Z-Coder672/P.A.R./Arduino Code/PARMain/FLOW.md

# P.A.R.Main Flow

## Hardware in 5 seconds

| Thing | What it does |
|---|---|
| Arduino Nano ESP32 | Main brain — WiFi, HTTP, NTP clock, servo, color sensor |
| Arduino Mega + GRBL | Motion controller — moves the gantry via `Serial1` (D0/D1) |
| ServoNano link (D9 TX, D2 ack) | `Serial2` TX-only to a dedicated 5 V Nano, which drives the flip servo (black ↔ blue). D2 reads its ack level |
| TCS3200 (D4–D8) | Color sensor — reads which side of a disc is showing |
| LED bank (D10) | Illumination for the ambient-subtracted read; HIGH = on |
| VL53L4CD (A4/A5, I²C) | ToF ranger — per-cell standoff, daily 10:00 scan only |

Full wiring — every pin, both boards, the GRBL/CNC-shield map and the ack divider — is in **`Arduino Code/PINOUT.md`**.

---

## Boot (`setup`)

1. **Init grid coords** — 37×18 = 666 cells, each mapped to a physical (X, Y) in mm (negative coords because GRBL homes to full-negative). Starting X offset = 25 mm.
2. **Bring up the servo link** (`Serial2`, TX-only on D9) and park the arm at `SERVO_US_REST` = 565 µs ≈ **2°** — not 0°. 544 µs is the Servo-library 0° floor and still appears as that floor in `SERVO_US_0DEG`/`SERVO_US_MIN`, in `compensatedUs()`'s degree mapping and in ServoNano's parse guard; it is **not** the rest angle.
3. **Configure TCS3200** — S0/S1 = HIGH/LOW → 20% freq scaling (full speed is too fast to measure)
4. **Connect WiFi** → `timeBegin()` starts NTP → `timeWaitForSync(30 s)` (bounded only so a dead network can't wedge `setup()` — failure unlocks nothing) → `cadenceLoadRecord()` reads the last lidar scan's date off flash → `lidarEnsure()` brings the VL53L4CD up so a wiring fault surfaces in the log at boot, not at 10:00. The boot `scanGrid()` is commented out — the first color scan happens lazily in `loop()` (first job, `gridStateFresh` false).

**`setup()` never moves the gantry.** GRBL bring-up (`$H` homing, `$1=255`, `G21`/`G90`) lives in `grblBringup()`, called from `loop()` only after `cadenceGate()` says the rig is clear to operate — trusted time-server clock AND daytime. A brownout reboot at 02:00, or a boot with NTP unreachable, sits parked (servo at REST, not one byte of G-code) instead of homing at night. The boot-time night sleep and the "we booted at 14:00 and still owe today's lidar scan" case are likewise handled by `cadenceGate()`, so the whole schedule lives in one place.

---

## Main Loop (`loop`)

```
cadence gate → no trusted time-server clock? → HOLD PARKED (no motion, no polling), retry in 30 s
             → night (20:30–09:59), re-checked after EVERY wake? → sleep until 10:00
             → scan owed but it's 18:00 or later? → sleep until 10:00, scan then
             → today's lidar scan not done? → run it (~50 min), persist to flash
grblBringup  → first clear daytime pass since boot: home + $1=255 + G21/G90 (no-op after)
poll server  → got bitmap? → re-scan board (skipped if last action was a clean scan) → display it → check pass → snapshot request → mark complete
                             → then: night window? → sleep until 10:00 : 10 min linger
             → no bitmap?  → wait 10s → repeat
```

### Step-by-step

**0. `cadenceGate()`** — the clear-to-operate gate, before any motion or server ingestion. See **Daily Cadence** below. **HARD RULE: with no trusted time-server clock it returns false and the rig holds parked — no polling, no scanning, not even homing.** There is no "uncadenced" fallback; `loop()` just waits 30 s and retries the gate.

**1. Poll** — `fetchNext()` opens a raw TLS socket to the server, `POST /next.php` with an `X-Snapshot-Secret` header (must be POST — intermediates may silently retry GETs, and each retry would pop a queue item the board never sees; the secret is required as of 2026-08-31, so **flash this sketch before deploying that server change** or every poll 401s). The response's `X-Gallery-Id` header is the entry id, validated digits-only by `isDigitsOnlyId()` before it is stored — it is interpolated into the `/complete.php` URL and the snapshot POST body

**2. Parse response**
- Status 200 + body = new bitmap (base64, 112 chars max)
- Body `"NONE"` or non-200 = queue empty, sleep 10s

**3. Decode** — base64 → 84 bytes = 666 bits (last 6 bits are unused padding), one bit per disc

**4. `scanGrid()` (conditional)** — re-home and re-read every cell with the TCS3200. **Skipped when `gridStateFresh` is set**, i.e. when `gridState[]` is already a *measured* picture of the board: on the first job after boot (reusing `setup()`'s scan), and after any job whose last board-touching action was a scan with no fixing after it — the check pass re-scanned and found ≤`CHECK_FIX_MAX_SKIP` wrong, or the draw flipped nothing at all (`gridStateFromScan`, carried across the idle at the end of the job). That scan already describes the final board, so repeating it costs ~70 min to learn what was just measured. Any flip after a scan makes the state *inferred* rather than measured (`displayBitmap` clears `gridStateFromScan` before its first flip), and the next job re-scans. When the scan is skipped, `rehome()` still runs if `needsRehome` is set — the end-of-job `$1=0` releases the steppers, so the gantry may have been nudged.

Otherwise the full sweep runs. It reseeds `gridState[]` so `displayBitmap` only flips cells that actually differ. The reading sweep runs with the **flip arm parked at REST** (`SERVO_US_SCAN` = `SERVO_US_REST` = 565 µs, changed 2026-08-10). It used to be dropped to ~33.5° so that — since the sensor trails the flip head by `SCAN_OFFSET_X` (−24.005 mm ≈ one cell pitch) — the lowered arm brushed the board and pushed through any squisk left at stage 1 (90°, half-rotated). That secondary settling job is abandoned: the arm now stays up for the whole scan, so the "carriage moves only with the servo at REST" invariant holds trivially (a dropped arm dragged across a populated board is what snapped the flip arm before), and half-rotated discs are no longer nudged during scanning — one left mid-rotation stays mid-rotation until the check pass re-flips it. Each cell is read with **LED ambient-subtraction** and classified by a simple blue-channel threshold (see Color Classification below); ambient subtraction removed the old room-light "blown regime", so the former `SCAN_C_CEILING` guard / sensor re-init recovery is gone.

**5. `displayBitmap()`** — over the band of rows that contain at least one differing cell, flip cells where `desired bit ≠ gridState`. Rows with no differing cells are **skipped entirely** (no move to them — the next flipping row is still entered via `moveToYSafe`, so Y travel stays at an X soft-limit). Returns the number of cells flipped (= cells that were wrong vs the target), used to gate the check pass.

**5b. Check pass** — after the first `displayBitmap()` completes, conditionally re-scan + re-fix. Two short-circuits, both keyed on `CHECK_FIX_MAX_SKIP` (=5):
- **First draw flipped ≤5 cells** → tiny job, few chances to fail → **skip the whole check pass** (no re-scan, no re-fix).
- **Otherwise** → re-run `scanGrid()` (reseeds `gridState[]` from the physical board, catching discs that didn't flip cleanly or were misclassified), then count mismatches vs the target. Re-run `displayBitmap()` **only if >5 cells are still wrong**; ≤5 are left as-is. The color sensor is ~99.5% accurate, so a full 666-cell scan misreads ~3 cells on average — ≤5 mismatches sit within that noise floor, so re-flipping them would more likely flip a *correct* disc than fix a real miss. Tolerating ≤5 doesn't lower display accuracy. One corrective pass at most.

When the check pass ends on that skip-the-fix branch, its scan is the last thing that touched the board — so it is carried over as the *next* job's scan (see step 4) instead of being thrown away.

**6. `flipDisc(x, y, catchByNextMove, inverted)`** — two-stage 180° rotation (+ optional second catch)

> **Servo-angle regime (changed 2026-08-09, merged from `FlipAllTest`).** `SERVO_US_RELEASE` went **1018 → 807** (≈46° → ≈25.5°) and `SERVO_US_ENGAGE` **1471 → 1317** (≈90° → 75°), and the release angle is now **lidar-standoff compensated per cell** instead of commanded raw. Those base angles are only valid **as a set** with the compensation (`RELEASE_EXTRA_REACH_MM`, `LIDAR_FIT_CMM`, `RELEASE_EDGE_ROW_TRIM_MM`) and with the target trims (`FLIP_TARGET_OFFSET_X`, `FLIP_NONINVERT_OFFSET_X`, `FLIP_SKEW_X_TOP` −1.5, `FLIP_CATCH_EXTRA_X`, the unload). Porting one half without the other leaves the flip wrong by tens of degrees. `SERVO_US_SCAN` was deliberately **pinned to the literal 889 µs** (~33.5°) rather than left derived from `SERVO_US_RELEASE` — the scan sweep is not part of the flip tuning and following RELEASE down would have raised the sweeping arm ~20°.

The absolute flip X is
`grid[y][x].x + FLIP_TARGET_OFFSET_X + flipSkewX(y) + (inverted ? FLIP_INVERT_OFFSET_X : FLIP_NONINVERT_OFFSET_X)`.
- `FLIP_TARGET_OFFSET_X` = **+2.0 mm** — global landing trim, every cell, +X = away from homing.
- `flipSkewX(y)` — linear column-lean correction, anchored at the **bottom** row: 0 at `y = GRID_H-1`, `FLIP_SKEW_X_TOP` (**−1.5 mm**, toward homing/−X) at `y = 0`. Net landing is +2.0 mm on the bottom row and +0.5 mm on the top row. Only the flip head shifts — scanning still targets cell centers.
- `FLIP_NONINVERT_OFFSET_X` = **−0.5 mm** on RTL rows only — a residual registration difference between the two sweep directions (the LTR/inverted direction is the confirmed-correct reference). Distinct from `FLIP_INVERT_OFFSET_X`, which compensates for hitting the opposite *face* of the squisk.

`inverted` is passed on **left-to-right sweep rows** (`ltr` in `displayBitmap`) and mirrors the whole X excursion: `dx = −FLIP_OFFSET_X`, so the arm clears the disc column toward −X and catches on the +X return. Two effects: the catch drives the squisk through its final 90° in the opposite rotational sense, so LTR rows **unwind the column-rod twist** the RTL rows wind in; and the return slide — the flip's last motion — now ends in the direction the sweep is already heading, so an LTR row no longer backtracks 16.8 mm before every next cell. **RTL rows keep the original flip** for exactly that reason: their −X return already points along the sweep. Coming at the disc from the other side puts the arm on the opposite face of the squisk, hence the **+11.0 mm** (`FLIP_INVERT_OFFSET_X`) shift of the flip target on inverted rows.

```
move gantry to disc (fx = cell X + 2.0 + skew + (inverted ? +11.0 : -0.5))
servo → ENGAGE (75°)   → settle 300ms  # rotates squisk 90°; NOT compensated
G91; X -unload; G90                    # arm unload, still at ENGAGE (1.5 mm, 4.0 mm on the off-board edge cell)
servo → REST (2°)      → settle 300ms
G91; X (dx + unload); G90              # clearing slide — lands at cell + dx regardless of the unload
servo → RELEASE (compensatedUs, ~845..983µs) → settle 100ms
G91; X (-dx ∓ FLIP_CATCH_EXTRA_X); G90 # catch stroke — sweeps 3.5 mm PAST the cell origin
#ifdef FLIP_SECOND_CATCH               # default OFF — commented-out //#define near FLIP_OFFSET_X
  servo → RELEASE2 (compensated)→ settle 100ms  # second catch: arm a further ~10° lower
  if !catchByNextMove:                  # only when the next move won't already do it
    G91; X +dx2; G90                    # explicit +X sweep (opposite the return)
    servo → REST (2°)    → settle 100ms
#else                                   # second catch disabled
  servo → REST (2°)      → settle 100ms # park; catchByNextMove ignored
#endif
```

**Arm unload.** At ENGAGE the arm is bearing against the squisk it just rotated, so before the servo lifts to REST the head backs off **opposite** the coming clearing slide — taking the contact force off the arm so it lifts away cleanly instead of dragging a loaded disc. The clearing slide then travels `dx + unload`, so net motion from the cell origin is unchanged. `FLIP_UNLOAD_X = 1.5 mm` normally; `FLIP_UNLOAD_X_EDGE = 4.0 mm` **only where the unload travels off the board**, which is direction-matched, not column-symmetric: `usesEdgeUnload(gx, inverted)` is `gx == GRID_W-1` on LTR/inverted rows (unload runs +X, off the right edge) and `gx == 0` on RTL rows (unload runs −X, off the left edge). Any other pairing would back 4 mm **into** the neighbouring populated column — do not "restore the symmetry". Set `FLIP_UNLOAD_X = 0.0f` to disable the feature entirely.

**Catch stroke.** The return travels `−dx` **plus `FLIP_CATCH_EXTRA_X` (3.5 mm) further in the same direction**, so the arm sweeps past the cell origin instead of stopping on it — that is what completes the second 90° consistently. Only the return is lengthened; the clearing slide stays at `FLIP_OFFSET_X`. Each cell re-establishes absolute X with `moveTo(fx)`, so the extra travel cannot accumulate.

**Lidar standoff compensation** (`LIDAR_COMP_MODE 1` — every cell). The arm is a lever that lies flat on the platform at `ARM_FLAT_DEG` (23°), so its perpendicular reach is `ARM_LEN_MM·sin(θ − FLAT)`; a cell whose standoff exceeds `LIDAR_REF_MM` (37.69) by *d* needs *d* more reach, giving `θ' = FLAT + asin(sin(θ − FLAT) + d/ARM_LEN_MM)`. `compensatedUs(baseUs, gx, gy)` applies that to `SERVO_US_RELEASE` per cell from the `LIDAR_FIT_CMM[18][37]` rod-bend table, and adds two terms **outside** the comp gate: `RELEASE_EXTRA_REACH_MM` (+4.496 mm global — shortened pusher pin, plus the +60 µs that holds the top rows steady under the 2026-08-20 re-tilt) and `RELEASE_EDGE_ROW_TRIM_MM` (−0.5 mm on the **top and bottom rows only**, whose rods sit closest to their mounts, are stiffest, and over-push at the interior's reach). Result over the board: **845..983 µs, mean 913**; nothing clamps at `SERVO_US_MIN`. The `LIDAR_FIT_CMM` vertical gradient was **re-tilted 2026-08-20** (+0.2972 mm/row, mean-preserving) — the pass-4 table had it inverted, having subtracted a fictitious drift measured on calibration squares that move when the board does not. Four independent full-board scans put bottom−top at **+1.67 mm [+1.35, +1.98]** where the old table said −1.24 mm. `ARM_LEN_MM` is the arm's length — the pin trim is a linear reach demand and belongs in `RELEASE_EXTRA_REACH_MM`, not in the lever arm. `LIDAR_COMP_MODE 2` (masked paired trial) exists only in `FlipAllMaskedTest`; PARMain `#error`s on it.

`dx = ±FLIP_OFFSET_X (16.8 mm)` — **− on inverted (LTR) rows, + on RTL rows** — and every stroke (clearing, unload, catch-with-extra) is capped so it never commands past `X=0` or `−X_TRAVEL`; the unload is *skipped* rather than clamped if it would breach. Simulated over all 666 cells × both row directions × all strokes: worst-case margins **12.775 mm at `X=0`** (col 36, row 17, RTL clearing slide) and **19.700 mm at `−X_TRAVEL`** (col 0, row 0, LTR clearing slide), zero breaches — so the caps never bind today; they're the net for future offset/pitch/skew changes.

**The second catch is gated behind `#define FLIP_SECOND_CATCH`, OFF by default** (commented `//#define` near `FLIP_OFFSET_X` — uncomment to re-enable). With it OFF the arm parks at REST after the catch stroke and `catchByNextMove` is ignored. With it ON: the catch always sweeps **+dx by ≥16.8 mm**, opposite the return — which under the mirror means *against* the row's sweep direction on both row directions. So `catchByNextMove` can no longer be folded into the caller's next move and callers pass `false`; `flipDisc` always emits its own +dx stroke and re-parks at REST. (The parameter stays in the signature so re-enabling the second catch needs no signature change.) `SERVO_US_RELEASE2 = SERVO_US_RELEASE − SERVO_US_10_DEG` — still derived, so it followed RELEASE down to 704 µs base, and it is lidar-compensated at use.

Each cell logs one plog line while the clearing slide runs: `f x<gx> y<gy> L|R rel<us> unl<tenths mm> dx<tenths mm> miss<ackMisses>`.

**7. `onDisplayComplete()`** — `GET /complete.php?id=<N>` tells the server the image is confirmed displayed.

**8. Release steppers, then linger *or* sleep** — `releaseSteppers()` sends `$1=0` + a tiny jog (`G0 X-0.1`, away from the `X=0` soft limit) to trigger the disable, and sets `needsRehome`. **Sync (`waitForIdle`) after the `$1=0` before the jog** — `$1=0` commits the settings block to the Mega's EEPROM, and grbl disables interrupts during the write, dropping the Serial1 RX bytes of anything pipelined behind it. Without the sync, the jog arrives garbled → `error:2` → the rest of the burst desyncs the `ok` accounting → 60 s `waitForIdle` watchdog → MCU reset. Same `waitForIdle`-after-`$1` guard is applied at boot and in `rehome()`.

Then the cadence decides how long to wait: `isNightHour` (≥ 20:30 **or** < 10:00, catching a job that finishes after midnight) → `sleepUntilMorning()`, otherwise the usual `delay(10 min)`. The check is here — not only at the top of `loop()` — so the rig never starts an hour-long job that would finish deep into the evening and then immediately start another. If the clock is invalid at this moment the linger runs, but the next `cadenceGate()` holds the rig parked before anything else can move.

---

## Daily Cadence

Three coupled pieces: a real wall clock, a daily lidar standoff scan, and a night sleep. The board is powered 24/7, so this is a **schedule**, not power management.

**Wall clock.** NTP over the WiFi link the poller already keeps up: `configTzTime(PAR_TZ, "pool.ntp.org", "time.nist.gov")`, timezone `MST7MDT,M3.2.0,M11.1.0` (US Mountain with DST) as a named constant. Started once WiFi is up and re-asserted (idempotently) at the top of every loop; SNTP re-polls on its own and survives a WiFi bounce. **Every** cadence decision goes through `localNow(struct tm&)`, which returns false unless `clockValid()`: (a) `time()` exceeds `TIME_VALID_FLOOR` (2025-01-01 UTC — the ESP32 RTC starts at the epoch and SNTP fills it in *asynchronously*, so the clock is readable long before it is true), (b) at least one SNTP fix has landed this boot (`onNtpSync` notification callback stamps each one), and (c) the newest fix is under `CLOCK_MAX_SYNC_AGE_S` (24 h) old — the internal RTC only *interpolates between* time-server fixes and is never trusted on its own. **With no trusted clock the rig holds parked: no scan, no sleep-decisions, no polling, no homing — no motion of any kind** — logged once every 5 min, retried every 30 s. The 24 h age bound comfortably covers the longest NTP-less stretch (the 16 h past-cutoff sleep with WiFi dropped) while guaranteeing a rig whose network dies stops moving within a day.

**Daily lidar scan (10:00 local).** `runDailyLidarScan()` sweeps the VL53L4CD over **rows 1–17 (629 cells)** and writes the result to flash; row 0's 37 cells are projected afterwards (see **Skipped top row** below). It runs when the clock says the hour is ≥ 10 **and** the flash record's date isn't today — which covers both "it just turned 10:00" and "we rebooted at 14:00 and owe today's scan". An owed scan is only **started before 18:00** (`LIDAR_SCAN_CUTOFF_HOUR`): at/after the cutoff the day is written off — the rig sleeps to 10:00 and runs the scan on wake — rather than sweeping ~50 min into the evening and then printing into the night. Sensor mechanics are ported from `ScanColorLidarTest`: free-running at a 50 ms timing budget, one fresh 4 s window per cell (~80 samples), reduced to a **20 %-trimmed mean in tenths of a mm**; head offsets `LIDAR_OFFSET_X = +31.075` (calibrated so col 36 targets exactly the `X=0` machine limit) and `LIDAR_OFFSET_Y = SCAN_OFFSET_Y + 6.0 = +14.0` (the top row's target computes to −14.2 + 14 = −0.2, inside GRBL's envelope — this is what the `$131` 406→412 bump bought — but the head *physically* jams there, which is why row 0 is skipped). Targets are clamped on **both** axes (`clampScanY`, and `clampScanX` as the mirror safety net).

**Skipped top row (`LIDAR_SKIP_TOP_ROW`).** The colour sensor sits +8 mm above the flip head and clears row 0 fine, so `scanGrid()` is untouched. The lidar sits +14 mm, and at that height the head **jams against the frame across the right-hand end of row 0** — and since `cellAt` makes row 0 an even (L→R) row, the sweep would *end* the row at col 36, target (`X 0.0`, `Y −0.2`), hard into the corner. A jam does not necessarily raise `ALARM`: the steppers just skip, silently corrupting every later cell until the `y == 8` rehome. So the sweep starts at `LIDAR_FIRST_ROW` (= 1) and row 0 is never visited at the lidar Y. `rowsDone` still counts from row 0, so the resume arithmetic is unchanged.

`projectSkippedTopRow()` then fills row 0 per column, so the stored record stays dense at 666: a least-squares **linear** fit in row index over that column's measured cells (centred at `t = y − 9` for conditioning), evaluated at `y = 0`. **Linear, not cubic, deliberately** — the offline cubic in `ScanColorLidarTest` is fit to a smoothed multi-pass curve, while this one gets a single sweep's raw cells at sd ≈ 2.88 mm per-cell noise, and extrapolating one step past the fitted range amplifies noise with the degree. Measured against the shipped `LIDAR_FIT_CMM` as ground truth (300 noise trials, mean |error| in mm at the documented 2.88 mm noise): **linear 1.37**, quadratic 1.88, hold-nearest-row 2.31, **cubic 2.82** — the cubic is worse than not projecting at all. `LIDAR_PROJ_DEGREE` changes it. The fit is **not** anchored to `LIDAR_FIT_CMM` even though that scores better, because these records are what the offline re-fit consumes to rebuild that table. Guards: a column with under `LIDAR_PROJ_MIN_POINTS` (8) measured cells, a singular solve, or a projection landing outside the column's own measured range ±5 mm falls back to holding the nearest measured row. `topRowProjected` in the flash record flags the synthetic row; `cellsOk` counts only measured cells (629 on a clean sweep).

Readings are stored **RAW**, matching that sketch's `LIDAR_APPLY_CALIBRATION 0` run: the back-colour distance offsets are only meaningful against a same-pass colour classification, and this sweep does not run the colour sensor. A half-applied correction would be worse than none — the correction belongs in the offline fit that produces `LIDAR_FIT_CMM`.

Motion obeys the same conventions `scanGrid()` does, for the same reasons: **flip arm parked at `SERVO_US_REST` for the whole pass** (a dropped arm dragged across a populated board is what snapped it before), serpentine order via `cellAt()` so end-of-row X equals start-of-next-row X, every cross-row leg through `moveToYSafe` (pure-Y travel only at an X soft limit), intra-row moves are pure X, nothing sensed until `waitForMotion()` confirms the carriage stopped, and a mid-scan `rehome()` after row 8 so step drift can't skew the second half. Per-cell flash writes are pipelined behind the travel to the next cell, exactly as in `scanGrid`. `gridState[]` is **not** touched — no disc is flipped, so `gridStateFresh`/`gridStateFromScan` carry through unchanged; `rehome()` clears `needsRehome`. Cost is ~4.3 s/cell ≈ **50 minutes**, which is why it is scheduled once a day and not paid by the print loop.

If the ranger never initialises, `lidarEnsure()` gives up after 10 attempts (re-initing I²C between them) and — **unlike `ScanColorLidarTest`, which halts** — the rig carries on printing. The day is recorded with `sensorOk = 0` and no cells, so a dead ranger costs one day of data instead of putting the rig in a loop that re-attempts a 50-minute sweep all day.

**Flash record.** One fixed-layout `LidarScanRecord` at `/cadence.bin` on the **same LittleFS mount plog uses** — the factory `ffat` partition (`LittleFS.begin(true, "/littlefs", 10, "ffat")`; see `persistent_log.cpp` for why it is not `spiffs`). plog mounts it at boot; `cadenceFsReady()` re-calls `begin()` only as a guard for the case where that mount *failed*, which returns true immediately when the label is already mounted, so plog's files are never touched or reformatted. The struct (**version 2** since 2026-08-25) holds magic / version / grid geometry / `sensorOk` / local `(tm_year, tm_yday)` / unix epoch / OK-cell count / **the `rowsDone` + `(progYear, progYday)` checkpoint** / `topRowProjected` / `uint16_t dist10[666]` / an FNV-1a checksum over everything preceding it. `topRowProjected` reuses what was reserved padding rather than appending a field, so the layout — and therefore the version — is unchanged and no re-scan is forced on upgrade: every record ever written zeroed those bytes, and 0 is exactly right for a record whose top row really was measured. Written temp-then-rename, same crash policy as plog's rotation. Anything unexpected on load — missing, wrong size, wrong magic/version/geometry, bad checksum — is treated as "no scan on record", so the failure direction is *re-scan*, never *skip*. **The stored `(year, yday)` is the authority for "has today's scan run"**, so a reboot at any hour resumes the schedule correctly.

**The sweep checkpoints every row.** `runDailyLidarScan()` writes the record at each row boundary with `rowsDone` and the `(progYear, progYday)` of the day in progress — deliberately *separate* fields from the `(year, yday)` done-stamp, which is still written only on completion, so a partial record can never read as done. On entry, a checkpoint from **the same local day** with `0 < rowsDone < GRID_H` resumes at visit-row `rowsDone` and keeps the cells already measured; anything else starts fresh. Before this, the record was stamped only at the end, so a mid-sweep MCU reset threw the whole pass away: on 2026-08-25 a serial-noise stall (see `grblIsOk`) reset the rig 7 times between 10:00 and 12:13, each boot restarting at cell 0 and never getting past row 8 of 18 — and since `cadenceGate()` only returns once the scan is done, the rig did not poll or print for three hours. A restart now costs at most one row. **If the flash write fails, the in-RAM record still counts** (`cadenceSaveRecord` marks it valid up front): a broken FS runs the schedule RAM-only until the next reboot — costing one extra scan after that reboot — instead of re-running the 50-minute sweep on every gate pass all day.

`LidarScanRecord` is declared near the **top** of the .ino, next to `GRID_W`/`GRID_H` and far from the code that uses it, for the same reason `TcsFilter` is: the Arduino IDE injects its auto-generated forward declarations immediately above the first function in the file, so any type named in a function signature must be complete by that point.

**Night sleep (20:30 → 10:00).** `isNightHour(h, m)` is `(h > 20 || (h == 20 && m >= 30)) || h < 10`, written once so the post-print check and the boot-time check can never disagree about the boundary. The start carries a minute component (`NIGHT_START_HOUR` / `NIGHT_START_MIN`); the 10:00 wake end is on the hour, so only the start needs minutes. `sleepUntilMorning()` parks the servo at REST, releases the steppers via `releaseSteppers()` if they're still energised, then idles: `delay(30 s)` ticks until an epoch wake target — the next 10:00 local, computed with `mktime` (`tm_isdst = -1`, so a sleep spanning a DST change still ends at 10:00 wall-clock) — with an hourly heartbeat line and a **17 h backstop** (longer than the longest legitimate sleep, 18:00 → 10:00 = 16 h in the past-cutoff case; short enough that a stuck clock costs one day rather than forever). The wake condition is an epoch compare, not "hour left the night window", because the past-cutoff owed-scan case enters sleep as early as 18:00 where an hour-window test would bounce straight out. On wake it re-establishes WiFi and re-asserts NTP. Nothing is polled and nothing is ingested during the sleep. The stepper release is skipped before the first `grblBringup()` of a boot (GRBL is still in its power-on alarm and its steppers are unpowered anyway). **`cadenceGate()` re-tests the night/owed-scan condition in a `while` loop after every wake**, so a spurious exit — the 17 h backstop firing after SNTP stepped the clock — lands straight back in sleep instead of falling through to a scan or a poll at a night hour; after the morning scan it re-verifies once more before allowing the poll (a mid-scan clock step can't leak a night job).

It is a plain `delay()` loop, **not** light or deep sleep, on purpose: `delay()` yields to FreeRTOS so the idle task still feeds the watchdogs, the `millis()`-based GRBL/WiFi stall watchdogs stay coherent, and no reset-cause breadcrumb is fabricated — deep sleep would reboot the SoC, log `ESP_RST_DEEPSLEEP`, and re-run the whole homing sequence, defeating the point of that breadcrumb. The RTC free-runs without the network, so the wake decision never depends on NTP staying reachable.

Ordering in `cadenceGate()` is sleep **first**, then scan, so the morning wake always lands on the scan check and the day's first print draws against fresh standoff data.

Log lines: `ntp start`/`ntp synced`/`ntp NOT synced`, `cadence: record …`, `cadence: lidar scan begin|end`, `cadence: resuming lidar scan at row N/18`, `cadence: record saved … rowsN`, per-cell `ld y<y>c<x> <mm.t> n<samples> mn<min> mx<max>`, `cadence: row 0 lidar SKIPPED (jams at lidar Y; projected after the sweep)`, `cadence: top row projected (deg<N> fit <n>, held <n> of 37 cols)`, `cadence: sleep at HH:MM until 10:00`, `cadence: sleeping HH:MM`, `cadence: wake`, `cadence: no trusted clock - holding parked (no motion, no polling)`.

---

## Color Classification

TCS3200 measures R/G/B/Clear light frequencies, read with **LED ambient-subtraction**: `readAmbientSubtracted()` averages `AMBIENT_FLASHES` (3) off/on flashes, each subtracting a 5-frame LEDs-off (ambient) read from a 5-frame LEDs-on (lit) read. This cancels room light so the value depends only on the disc + our own LEDs.

```
if c <  SCAN_ON_CLEAR_MAX (900)  ->  cyan/on (1)
else                             ->  black/off (0)
```

Single threshold on one ambient-subtracted channel: the `c` slot of `tcsReadRGBC`, fed from
TcsFilter value 2, commanded (S2=H, S3=L). No model (the ternary classifier is retired).

**Reversed 2026-08-22.** From 2026-08-20 the code thresholded the `b` slot (value 1) at
1112. That is the wrong channel: its two populations overlap and no cut separates them.
Ground truth, 666 cells of one check-pass scan compared against the source bitmap decoded
from `gallery.php`, best achievable errors per slot: r = 7, g = 6, **b = 14**, **c = 6**.
Live on `b` at 1112 the same scan scored **24**. Corroborated across 40 earlier jobs
(ids 26–66, 26,640 cells) whose firmware thresholded `c`: 89 errors, **0.33 %**. On job 42
that firmware scored 0 errors while the best possible score on `b` was 17 — `b` was never
the channel being read, whatever the labels said.

Do **not** re-derive the channel from a sum test (unfiltered ≈ sum of filtered). That
identity does not hold on this sensor at either supply — at 3V3 the `g` slot reads ~5× the
`c` slot — and it is what produced both the "S2/S3 are crossed" theory and the 2026-08-20
reversal of it. Measure against a known bitmap; the check pass gives you one for free.

900 is the geometric mean of the clean cluster edges (cyan p95 = 494, black p05 = 1651).
The error count is flat at 6–7 anywhere from ~700 to ~1400, so it sits mid-plateau.
Separation at 3V3 is 4.93× (black p05 / cyan p95) against a 5 V-era median of 5.52×.
**It is supply-dependent** — re-derive if the TCS3200 moves off 3V3. Old logs are not
column-comparable: slot semantics have changed twice. Full measurements are in
`PARMain.ino` at `SCAN_ON_CLEAR_MAX`; wiring is in `Arduino Code/PINOUT.md`.

**The sensor views the disc BACK**: a displayed-on (cyan-front) disc shows its black back → reads LOW; displayed-off shows its cyan back → reads HIGH. `classifyDisc` returns the FRONT/displayed color (`on = channel below threshold`), matching `gridState`'s convention. Ambient subtraction removed the old "blown regime" (bright ambient made every cell read the same → garbled draw), so the former `SCAN_C_CEILING` guard / re-init recovery is gone.

---

## GRBL Streaming

GRBL's RX buffer = 128 bytes. Code tracks how many bytes are in-flight:

- `sendGcode()` — blocks if buffer would overflow, then sends + tracks length
- `drainResponses()` — reads GRBL replies; each `ok` frees the bytes for that command
- **Response matching is tolerant, not exact.** `grblScrub()` drops non-printable bytes, then `grblIsOk()` / `grblHasError()` / `grblHasAlarm()` match on *substring*, not equality. Line noise arrives as junk glued to the front of a reply — `\xffok` (2026-08-23), then `Dok` / `Pok` / `Tok` / `Vok` / `}S?xok` (2026-08-25) — and an exact `resp == "ok"` treats each one as a lost ack: the queue slot is never dequeued, `bufferFill` never drains, and 60 s later the stall watchdog resets the MCU. `grblIsOk` accepts a line ≤ `GRBL_OK_MAX_JUNK_LEN` (8) chars containing `ok` and neither `error` nor `ALARM`; no legitimate GRBL response contains the substring `ok`, so nothing real can be swallowed. Recoveries are counted (`gRxCorruptOks`) and logged, because this masks a hardware fault
- `grblDropIdleNoise()` — called at the top of `sendGcode()`. Whenever nothing is outstanding (`bufferFill == 0` and the queue is empty), anything already in the RX buffer is either a complete unsolicited line (logged as `GRBL idle line:`) or an orphan fragment with no newline, which is dropped before the next genuine `ok` can complete the line around it. That fragment *is* the corruption mechanism above
- `waitForMotion()` — sends `G4 P0` (dwell) + `waitForIdle()` so `ok` means motion *actually finished*, not just "parsed into planner"

---

## Error handling

| Situation | Response |
|---|---|
| GRBL `error:N` | Re-send the same command, up to `MAX_ERROR_RETRIES` (10) at 3 s spacing per same-command run; a clean `ok` resets the counter. Exhausted → park servo → `esp_restart()` |
| GRBL `ALARM` | `grblAlarmRecover()` — Ctrl-X soft reset → `$H` → reassert modals → clear the queue → force a re-scan next job. Any sub-step failing → `esp_restart()` |
| GRBL comms wedged (60 s no progress) | `grblStallReset()` — park servo → `esp_restart()` |
| Reply corrupted by line noise | `grblScrub()` drops non-printables; `grblIsOk`/`grblHasError`/`grblHasAlarm` match by substring so a surviving printable junk byte can't lose the ack. Counted in `gRxCorruptOks` / `gRxIdleDropped` |
| Servo command unacked (`SERVO_ACK_MODE 2`) | Re-send and **retry forever**. Blocking is the safe failure: every call site is reached with GRBL idle. Deliberately does *not* reset — a reset re-homes, and homing with the arm possibly at ENGAGE is how the arm broke |
| WiFi down > 60 s | Park servo → `esp_restart()` |
| `next.php` poll failure | Log, wait 10s, retry |
| Bitmap wrong length | Log, wait 10s, retry (the 10s back-off is load-bearing — `next.php` pops an item per call, so retrying with no delay would drain the queue) |
| `snapshot-request.php` failure | Log only. **No retry** — a missed snapshot just leaves `gallery/<id>/image.*` absent |
| `complete.php` failure | Exponential back-off 1s→60s over a 5-minute budget; on exhaustion the id is dropped and the entry stays `pending` server-side |
| VL53L4CD init fails ×10 | Log, record the day with `sensorOk = 0`, **keep printing** |
| NTP never syncs | HOLD PARKED — no motion, no polling, not even homing; log every 5 min, retry every 30 s |
| NTP fix goes stale (> 24 h, e.g. router dead) | Same hold-parked state as never-synced; recovers on the next fix |
