Z-Coder672/P.A.R./media/social/facebook.png

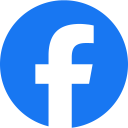
media/social/facebook.png
