Z-Coder672/P.A.R./media/social/reddit.png

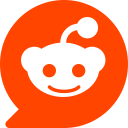
media/social/reddit.png
