Z-Coder672/P.A.R./media/social/x.png

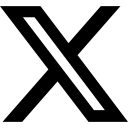
media/social/x.png
