Z-Coder672/P.A.R./PCBnSCHs/PCB_PCB3_Shield_2026-08-16_Top_Copper.png

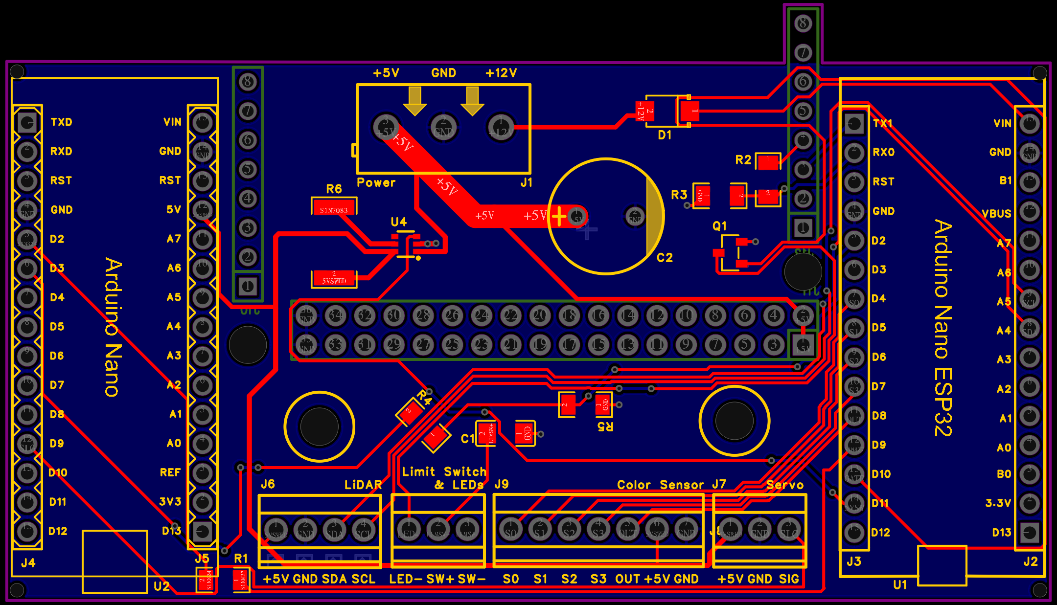
PCBnSCHs/PCB_PCB3_Shield_2026-08-16_Top_Copper.png
