Z-Coder672/P.A.R./PCBnSCHs/BOM_Board3_Shield_PCB3_Shield_2026-08-22_V7.xlsx

No. | Quantity | Comment | Designator | Footprint | Value | Manufacturer Part | Manufacturer | Supplier Part | Supplier
1 | 1 | 1nF | C1 | C1206 | 1nF | 1206B102K202NT | FH(风华) | C9196 | LCSC
2 | 1 | 1500uF | C2 | CAP-TH_BD10.0-P5.00-D1.0-FD | 1500uF | RZW152M1CBK-1025 | Lelon(立隆) | C411234 | LCSC
3 | 10 | 100nF | C3,C6,C8,C10,C12,C13,C14,C16,C17,C19 | C0603 | 100nF | CL10B104KB8NNNC | SAMSUNG(三星) | C1591 | LCSC
4 | 6 | 10uF | C4,C7,C9,C11,C15,C18 | C1206 | 10uF | CL31B106KAHNNNE | SAMSUNG(三星) | C14860 | LCSC
5 | 1 | 470uF | C5 | CAP-TH_BD8.0-P3.50-D0.6-FD | 470uF | RXK471M1CBK-0811 | Lelon(立隆) | C231191 | LCSC
6 | 1 | M7F | D1 | SMAF_L3.5-W2.6-LS4.7-RD |  | M7F | HT(金誉) | C49384260 | LCSC
7 | 1 | SMBJ5.0A | D2 | SMB_L4.3-W3.6-LS5.4-RD |  | SMBJ5.0A | PDW(芯格诺科技) | C49242966 | LCSC
8 | 1 | KF301-5.0-3P | J1 | CONN-TH_3P-P5.00_KF301-5.0-3P |  | KF301-5.0-3P | KEFA(科发) | C474882 | LCSC
9 | 4 | KH-2.54FH-1X15P-H8.5 | J2,J3,J4,J5 | HDR-TH_15P-P2.54-V-F |  | KH-2.54FH-1X15P-H8.5 | kinghelm(金航标) | C2932676 | LCSC
10 | 1 | KF128-2.54-4P | J6 | CONN-TH_4P-P2.54_KF128-2.54-4P |  | KF128-2.54-4P | KEFA(科发) | C474922 | LCSC
11 | 2 | KF128-2.54-3P | J7,J9 | CONN-TH_3P-P2.54_KF128-2.54-3P |  | KF128-2.54-3P | KEFA(科发) | C474921 | LCSC
12 | 1 | KF128-2.54-7P | J8 | CONN-TH_7P-P2.54_KF128-2.54-7P |  | KF128-2.54-7P | KEFA(科发) | C474925 | LCSC
13 | 2 | 2.54-1*8 | J10,J12 | HDR-TH_8P-P2.54-V-M |  | 2.54-1*8 | ZHOURI(洲日) | C5156616 | LCSC
14 | 1 | HC-PZ254-11.5L-2x18PZ | J11 | HDR-TH_36P-P2.54-V-M-R2-C18-S2.54-1 |  | HC-PZ254-11.5L-2x18PZ | HC(虹成电子) | C41376109 | LCSC
15 | 1 | AO3400A | Q1 | SOT-23-3_L2.9-W1.3-P1.90-LS2.4-BR |  | AO3400A | ChipNobo(无边界) | C42419946 | LCSC
16 | 1 | AO3401A | Q2 | SOT-23_L2.9-W1.3-P1.90-LS2.4-BR |  | AO3401A | AOS | C15127 | LCSC
17 | 1 | 330Ω | R1 | R1206 | 330Ω | CR1206J40331G | LIZ(丽智电子) | C102333 | LCSC
18 | 2 | 2kΩ | R2,R4 | R1206 | 2kΩ | CR1206J40202G | LIZ(丽智电子) | C102302 | LCSC
19 | 4 | 3.3kΩ | R3,R5,R10,R11 | R1206 | 3.3kΩ | CR1206F43301G | LIZ(丽智电子) | C102170 | LCSC
20 | 1 | 1kΩ | R6 | R2512 | 1kΩ | 25121WF1001T4E | UNI-ROYAL(厚声) | C54315 | LCSC
21 | 3 | 100kΩ | R7,R8,R9 | R0603 | 100kΩ | 0603WAF1003T5E | UNI-ROYAL(厚声) | C25803 | LCSC
22 | 1 | 1kΩ | R12 | R0603 | 1kΩ | RCC06031K00FKEA | VISHAY(威世) | C1859322 | LCSC
23 | 1 | MF-NSMF200-2 | U3 | F1206 |  | MF-NSMF200-2 | BOURNS | C89656 | LCSC
24 | 1 | TPS22919DCKR | U4 | SC-70-6_L2.2-W1.3-P0.65-LS2.1-BR |  | TPS22919DCKR | TI(德州仪器) | C2149796 | LCSC
