Z-Coder672/P.A.R./grbl_mega_backup.txt

$0=10
$1=255
$2=0
$3=0
$4=0
$5=1
$6=0
$10=1
$11=0.010
$12=0.002
$13=0
$20=1
$21=1
$22=1
$23=3
$24=50.000
$25=2000.000
$26=244
$27=2.500
$30=1000
$31=0
$32=0
$100=40.000
$101=40.000
$102=250.000
$110=5000.000
$111=5000.000
$112=500.000
$120=100.000
$121=100.000
$122=10.000
$130=777.695
$131=402.000
$132=200.000
