Z-Coder672/P.A.R./(commit log)

2026-05-08 Initial commit: P.A.R. LED matrix display project
    Full stack: PHP backend (queue, gallery, snapshot endpoints), vanilla-JS
    SPA frontend, Python YT-Streamer (livestream + snapshot uploader),
    Arduino sketches (main display loop, motion, color-sensor ML), and the
    PyTorch training pipeline for the disc color classifier.
    [grbl_mega_backup.txt]
2026-06-11 Add per-print recording pipeline, mod queue, and Arduino flip/logging work
    Website/PHP:
    - Per-print YouTube recording flow: stream-start/end/end-set, stream-video-id,
    latest-video endpoints and Latest-tab embed
    - Moderation queue: queue/mod-next/mod-action/migrate-mod-queue endpoints
    - Split monolithic livestream-api.php into focused endpoints
    - gallery/next/enqueue refinements; video-status
    YT-Streamer:
    - Record orchestrator + background uploader, snapshot poller, mod poller
    - Refactor RTSP -> local USB webcam via ffmpeg avfoundation (RTSP archived)
    Arduino:
    - PARMain flip/scan/classifier rework + persistent_log
    - New servo/wifi/validate test sketches; PlogDump
    [grbl_mega_backup.txt]
2026-06-11 Fix scanGrid top-row ALARM:2 + log offending move on alarm
    The top bitmap row's scan target was grid Y -1.895 + SCAN_OFFSET_Y(+4.0)
    = +2.105, past the Y=0 soft-limit edge -> GRBL ALARM:2 (target > 0).
    Raising $131 (now 402) only extends the -Y end; the +Y/Y=0 edge is capped
    at 0 regardless. clampScanY()/SCAN_Y_MAX now pin every scan Y just inside
    the envelope (top row reads ~2mm low, still on the disc).
    Also: drainResponses logs the in-flight G-code on ALARM so the next plog
    dump names the exact offending move. Sync grbl_mega_backup.txt ($131=402)
    and document the Y_TRAVEL-vs-$131 decoupling in CLAUDE.md.
    [grbl_mega_backup.txt]
2026-06-11 Sync Y_TRAVEL to $131=402 — homing anchors the grid at the -Y switch
    Homing drives to the -Y switch and GRBL pins that corner at -$131, so the
    switch is the physical coordinate anchor: Y_TRAVEL must equal $131 or the
    whole grid shifts by the difference. Update Y_TRAVEL 399.695 -> 402.0 in
    PARMain and all six mirror sketches.
    With the frame re-anchored, Y=0 now sits 2.305mm above the grid top, so
    the top-row scan target is -0.2 (was +2.105 under $131=399.695) — the
    real fix for the scanGrid ALARM:2. clampScanY stays as a safety net;
    comment updated to reflect that. Correct the prior CLAUDE.md note that
    wrongly said Y_TRAVEL and $131 are deliberately decoupled.
    [CollectColorTrainingData.ino, FlipCheckerboardTest.ino, FlipCornersTest.ino, PARMain.ino, ValidateColorModelCheckerboard.ino, ValidateColorModelLuv.ino, WiFiAfterSetupTest.ino]
2026-06-11 Surface missing-ffmpeg error distinctly from missing-camera in YT-Streamer
2026-06-11 Arm snapshot flag from Arduino post-check-pass, not next.php
    next.php no longer writes snapshot-pending.flag at queue-pop time — that
    armed the 5s snapshot poller before the draw started, capturing mid-draw
    boards. snapshot-request.php now accepts the digits-only id the Arduino
    POSTs after its check pass and writes it as the flag contents (empty for
    legacy IDless captures).
2026-06-13 Add ServoRepro sketch: hammer top-left corner flip via production servo path
    Reproduces the in-job servo failure without WiFi/scan. Strip-down knobs
    (DO_X_MOVES, DO_HOMING) at the top. Uses the bit-banged-UART -> ServoNano
    path exactly as PARMain, so the failure mode matches production.
    [ServoRepro.ino]
2026-06-13 ServoRepro: strip to servo-only max-duty (DO_X_MOVES=0) to stress power/thermal
    Carriage stationary -> both witness and main ROIs become gantry-free and
    directly comparable; ~3x servo duty cycle accelerates any sag/thermal onset.
    [ServoRepro.ino]
2026-06-13 ServoRepro: add TRAVERSE mode — loop all 4 corners for full-board wire flex
    Full X/Y travel each loop stresses the main servo's long flexing wire to the
    moving carriage, the prime suspect now that in-place flips (~520 cycles) never
    reproduced the failure with a perfect signal path.
    [ServoRepro.ino]
2026-06-13 Add ServoCenter sketch: hold servo at 90deg center, never moves carriage
    Servo PSU was cut after a carriage move broke a part. This sketch drives only
    the servo (bit-bang UART -> ServoNano) to center and never starts Serial1/GRBL,
    so it is safe to power on during reassembly.
    [ServoCenter.ino]
2026-06-13 ServoCenter: hold REST (544us / 0deg) instead of 90deg, per user
2026-06-13 ServoRepro: faithful displayBitmap loop using PARMain's safe motion
    Replaces the unsafe naive-diagonal traversal (which broke a part) with PARMain's
    exact serpentine displayBitmap + moveToYSafe + flipDisc(second-catch off), so the
    carriage only moves with the servo at REST. Toggles top+bottom rows to force 74
    flips/pass with full-board travel — a true normal-job load for the main-vs-witness
    servo diagnosis.
    [ServoRepro.ino]
2026-06-13 Add ServoCycle: zero-motion sustained servo cycling for main-vs-witness diagnosis
    Cycles the servo through flip angles forever via the ServoNano path, never
    touches GRBL/Serial1 (carriage cannot move). For reproducing 'main stops while
    witness continues' under sustained duty, with both servos in camera view.
    [ServoCycle.ino]
2026-06-13 ServoRepro: robust + logged GRBL handling for diagnostic job run
    Logs every GRBL response to USB, retries transient error:N, and parks+halts
    with a printed cause on ALARM/stall (instead of silent while(true)). Lets the
    faithful displayBitmap job survive transients and reveal why it stopped at
    flip 34, while watching for the main-servo failure (visible during top-row flips).
    [ServoRepro.ino]
2026-06-13 Add ServoYFlex: full-Y-travel wire-flex test, observe main at visible top-left corner
    Main is only visible at Y~0/X~-X_TRAVEL. This traverses Y up/down at the left
    edge (safe pure-Y at the soft-limit, servo at REST) to flex the main's long
    moving-carriage wire, cycling the servo at the top-left each iteration so the
    main can be compared against the always-visible witness.
    [ServoYFlex.ino]
2026-06-13 ServoYFlex: stress bottom-right corner (where it often fails), verify main at top-left
    Per user: failure is positional — carriage at full-right / bottom-right corner.
    Safe full-perimeter excursion (pure-Y at left edge, pure-X along bottom row, no
    diagonal field sweep), cycling the servo at the bottom-right corner and at the
    visible top-left for main-vs-witness verification.
    [ServoYFlex.ino]
2026-06-13 ServoRepro: full-board checkerboard pattern for max-volume normal-job repro
    Inverts a checkerboard each pass so every cell flips (~333 flips/pass) across
    the whole board incl. bottom-right — closest stand-in for a real job's servo
    duty + traversal, to reproduce the main-servo failure that targeted sub-motions
    (stationary, Y-flex, corner-stress) did not.
    [ServoRepro.ino]
2026-06-13 ServoRepro: log each flip cell+time for failure-cell correlation
    [ServoRepro.ino]
2026-06-13 ServoRepro: fix startMs scope (declare before displayBitmap)
    [ServoRepro.ino]
2026-06-13 Add ServoWiggleTest: hold carriage at bottom-right + cycle servo to localize main cable open
    Diagnosis: main fails on the right (max extension) while witness stays fine ->
    intermittent open in the main servo's own cable/connector when pulled taut.
    This parks at bottom-right and cycles the servo so the cable/connectors can be
    flexed by hand to find the bad spot.
    [ServoWiggleTest.ino]
2026-06-14 Add flip/scan diagnostic sketches; gitignore local image artifacts
    New bring-up sketches: FlipBottomRowBlueTest, FlipLeftColumnTest,
    FullBoardScanTest, ScanFlipRegistrationTest. Updates to PARMain.ino +
    FLOW.md and the existing Servo*/Flip* sketches; CLAUDE.md touch-ups.
    Add .gitignore rules for the root-level rig photo / bitmap-dump scratch
    (IMG_*, P.A.R. Pics/, Pics of par again yay/, centers/, consensus*,
    photo-bitmap/) so ~240MB of local debug artifacts stay out of history.
    [FlipBottomRowBlueTest.ino, FlipCheckerboardTest.ino, FlipCornersTest.ino, FlipLeftColumnTest.ino, PARMain.ino, ScanFlipRegistrationTest.ino, ServoCycle.ino, ServoRepro.ino]
2026-06-15 PARMain: sync past $1 EEPROM write before pipelining more G-code
    $1=0/$1=255 commit the settings block to the Mega's EEPROM, and grbl
    runs each changed byte under cli() with a busy-wait on EEPE — dropping
    the Serial1 RX bytes of anything pipelined right behind it. That
    garbled the end-of-job release jog into error:2, desynced the ok
    accounting, and tripped the 60s waitForIdle watchdog into an MCU reset.
    Add waitForIdle() after every $1 write (job-end release in loop(),
    boot in setup(), and rehome()) so the next line goes out only after
    the EEPROM commit's ok lands. setup() also guards the $1 sync with the
    grblStartupFault restart path. FLOW.md step 9 updated to match.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
    [PARMain.ino]
2026-06-15 Add -update 1 to snapshot grab — ffmpeg 8.x image2 muxer rejects fixed filename
    ffmpeg 8.x's image2 muxer now refuses a single fixed output filename without
    -update 1 (it wants a %d sequence pattern otherwise). It still decodes the frame
    and writes a valid JPEG, but exits non-zero, so grab_snapshot()'s returncode==0
    check treated the grab as failed and unlinked the good file — surfacing as
    "Conversion failed!" with no photo reaching the gallery. The recording sidecar
    output already had -update 1; only the standalone one-shot grab was missing it.
2026-06-15 Fix grey/corrupted recordings — pin avfoundation capture mode
    The record ffmpeg requested -framerate with no -video_size, so avfoundation
    config failed and fell back to the cam's default mode. ffmpeg then couldn't
    estimate the rate and handed libx264 a garbage ~5000fps timebase, blowing the
    H.264 MB-rate level limit — producing a grey, corrupted file.
    Pin -video_size (CAMERA_VIDEO_SIZE, default 1920x1080) + -pixel_format uyvy422,
    force CFR output (-fps_mode cfr -r <framerate>, -pix_fmt yuv420p) over
    -use_wallclock_as_timestamps 1 (the Brio drops to ~15fps in dim light), and
    drop +faststart (conflicts with the fragmented-mp4 flags). Verified end-to-end:
    clean 1080p30 h264 from the first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
2026-06-15 Stop recording on snapshot signal, not Arduino stream-end
    The per-print recording only stopped when the Arduino POSTed stream-end-set.php
    after its full display + 10-min linger. An Arduino crash anywhere in that window
    (as happened — after a successful snapshot request) orphaned the recording until
    ffmpeg's 1.5h cap.
    Collapse the two "print done" signals into one: the snapshot request now also
    stops the recording. No server-side changes.
    - Arduino: remove sendStreamEnd() call + function; sendSnapshotRequest() is the
    sole post-display signal. The 10-min linger stays (paces polling) but is no
    longer recorded.
    - YT-Streamer: poll_snapshot_queue records a stop signal (gallery id + monoto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
    [PARMain.ino]
2026-06-15 PARMain: log reset cause at boot to catch silent scanGrid reboots
    Three consecutive jobs died right at `scanGrid begin` with no reason line
    in the flash log. Every NVIC_SystemReset path logs+flushes before resetting
    (plog is fsync-per-line), and a Cortex-M0+ with no watchdog armed locks up
    on a hard fault rather than rebooting — so a *silent* reboot is a power
    event (POR/brownout), not firmware.
    Add a boot breadcrumb that distinguishes warm vs cold resets via the RP2040
    watchdog scratch cookie (survives software reset, wiped by POR/brownout),
    plus the raw chip_reset register as a cross-check. Next silent reboot will
    be labelled COLD/power, confirming the brownout hypothesis.
    Co-Authored-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
    [PARMain.ino]
2026-06-15 Record via native AVFoundation (PyObjC), not ffmpeg — true 1080p30
    ffmpeg's avfoundation input can only request the camera's uncompressed
    device formats, and uncompressed 1080p over USB 2.0 is bandwidth-capped
    to ~5fps. Replace the ffmpeg subprocess recorder with a native
    AVCaptureSession (AVFRecorder) that selects the MJPEG-backed ('420v')
    1080p30 device format — the same one Photo Booth uses — for a true
    1080p30 recording.
    - New AVFRecorder class: AVCaptureMovieFileOutput for the H.264 mov plus
    a throttled VideoDataOutput writing the ~1fps latest_frame.jpg sidecar
    (the snapshot poller's no-contention source while a recording owns the
    cam). Audio is never captured — only a vi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
2026-07-15 PARMain plog: enlarge flash FS to 8 MB with brownout-safe rolling trim
    Move the log filesystem to the upper 8 MB of QSPI flash and raise the
    rotation cap to 4 MB so many jobs' per-cell scan dumps survive across the
    brownout reboots being chased. On overflow, stream the most recent 2 MB
    tail to a temp file and swap it in (a rolling trim, not a wholesale wipe);
    begin() recovers a leftover temp if a brownout hit mid-swap. Cap the
    RAM-held boot snapshot separately at 24 KB (tail only). PlogDump mirrors
    the new FS offset/size constants.
    [PlogDump.ino, persistent_log.cpp]
2026-07-15 PARMain: blown-sensor scan recovery + GRBL stream diagnostics
    Two fixes for garbled prints. (1) Blown-sensor regime: on some cold boots
    the TCS3200 front-end reads 2-4x too bright, every cell classifies black,
    the board reads empty and the whole image is redrawn. scanGrid now counts
    over-bright cells (clear-channel > SCAN_C_CEILING); if too many, it bails
    the sweep, re-asserts the S0/S1 scaling via the new initColorSensor()
    helper, and re-scans (no MCU reset, which would orphan the popped item).
    The scan sweep also drops the flip arm to SCAN (~12.5deg below RELEASE) to
    brush through any half-rotated stage-1 squisk, lifting to REST for homing.
    (2) GRBL stream accounting: gCmdsSent/gOksAcked c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
    [FlipCheckerboardTest.ino, PARMain.ino]
2026-07-15 Add file-based rate limiting on public endpoints
    Introduce the off-webroot private store (lib/env.php, lib/private_store.php
    providing par_private_dir()) and lib/ratelimit.php, a dual token-bucket
    limiter (best-effort per-IP keyed on CF-Connecting-IP plus a global cap)
    with state under PRIVATE_DIR/ratelimit. Fails open on any FS error. Applied
    to enqueue (strict) and the polled public reads queue/gallery/latest-video/
    video-status (generous, tuned so the 5s frontend polls never trip;
    video-status limits also shield the YT Data API quota). Keeps Site5 shared
    hosting from flagging the account under load.
2026-07-15 Add opt-in submitter email notifications; unify the print-done event
    Optional email on submission is encrypted at rest (libsodium secretbox)
    under PRIVATE_DIR/emails, keyed by an opaque id — never written to any
    web-served queue/gallery file, which carry only a notify flag. Lifecycle
    (helpers in lib/private_store.php): enqueue stores it; mod-action carries
    sub_id on approve and discards on reject; next.php binds it to the gallery
    id at pickup; snapshot-request atomically claims and sends on completion.
    snapshot-request.php now also finalizes the gallery entry (pending.json ->
    info.json), making it the single server-side "print done" event, so the
    Arduino's complete.php call is a redundant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
2026-07-15 Harden .htaccess: deny data files, lib/, and private dirs
    The frontend only ever fetches *.php, so raw data files are never needed
    by a browser. Deny .log/.flag/.enc/email.key/queue.txt/mod_queue.txt/
    latest-video.json/pending|info.json outright, and block the lib/ and
    par-private/ directories. Defense-in-depth in case a private file ever
    lands inside the served tree.
2026-07-15 gallery.php: derive pending from photo; video-status.php: report duration
    A gallery entry with a real photo is always done (the photo is only taken
    post check-pass), so force pending=false when image is present — a finished
    print never reads "In progress" even if its pending->info rename was lost.
    video-status.php now also parses the ISO 8601 duration into whole seconds
    so the client can open playback near the end of the recording.
2026-07-15 Frontend: homepage redesign, IFrame video playback, gallery deep-links
    Rebuild the Latest tab into a home page (hero, timelapse video, showcase
    sections, three-step explainer, CTAs) with scroll-reveal animation, backed
    by the new media/ clips. Embed recordings via the YouTube IFrame Player API
    instead of a bare iframe so playback can seek to ~10s before the end
    (opening on the finished board) with zero YT Data API calls; the latest
    recording now comes from the gallery list. Gallery modals are deep-linkable
    via a #<id> hash (openable from a URL, shareable, refresh-safe), which the
    completion email link targets.
2026-07-15 Frontend: optional email field in the upload modal + rate-limit UX
    Add the optional "notify me when it prints" email input to the name modal,
    with client-side validation, reset on cancel, and a confirmation message
    when provided; the address is sent to enqueue.php only when valid. Surface
    a friendly message on 429 rate_limited responses.
2026-07-15 docs: document email notifications, rate limiting, and gallery deep-links
    Update CLAUDE.md for the email-notification store, the file-based rate
    limiter, PRIVATE_DIR, the unified snapshot-request print-done event, the
    photo-derived gallery pending state, and the #<id> deep-link convention.
    Trim completed items from PARtodos.
2026-07-16 YT-Streamer: fix silent-empty recordings (camera TCC) + record hardening
    Recordings had been silently empty since a 2026-07-14 restart: the daemon runs
    as org.python.python (Python.app), which has no camera usage string and holds no
    TCC grant, so under a detached/launchd/SSH launch the AVCaptureSession starts but
    streams ZERO frames — empty .mov, dead snapshots — with nothing logged. It only
    ever worked because it was previously launched from an already-granted Terminal
    whose grant it inherited as the "responsible" process.
    Fix — give the daemon a real, promptable, signed bundle identity:
    - PARRecorder.app (com.par.ytstreamer): ad-hoc-signed bundle WITH
    NSCameraUsageDescription. Its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
2026-07-26 YT-Streamer: standalone fixed-duration Brio recorder
    record_clip.py records N minutes from the local USB webcam to a .mov,
    independent of the daemon (no .env, no vault, does not touch stream.log).
    Distilled from AVFRecorder, keeping the constraints that matter: native
    AVCaptureSession over the MJPEG-backed 420v format (ffmpeg's avfoundation
    input caps 1080p at ~5fps over USB 2.0), the device's own frame-duration
    rational, a pinned H.264 bitrate, and the main-thread CFRunLoop that keeps
    stopRecording() from deadlocking.
    Adds two gates the daemon learned the hard way: an explicit camera-TCC
    check (an unauthorized session starts but streams zero frames, yielding a
    silently empty file) and a fr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
2026-08-10 Port firmware to Arduino Nano ESP32; merge tuned flip geometry into PARMain
    The Nano RP2040 Connect's USB connector tore off, so the whole Arduino
    codebase moves to an Arduino Nano ESP32 (ESP32-S3 / NORA-W106). No rewiring
    was needed — the S3's GPIO matrix maps any UART to any pin, so only begin()
    calls changed.
    Port (all 38 sketches compile for arduino:esp32:nano_nora):
    - WiFiNINA -> native WiFi.h + WiFiClientSecure, with a 6-root CA bundle
    (par_root_ca.h). The site is behind Cloudflare, which rotates Universal SSL
    across Let's Encrypt / Google Trust Services / SSL.com without notice, so
    pinning a single root would silently brick TLS on renewal.
    - Serial1 explicitly pinned to D0/D1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
    [pass1_dump.txt, pass2_dump.txt, pass3_dump.txt]
2026-08-11 PARMain: reuse the check pass's scan when nothing was fixed after it
    A job's check pass usually ends by re-scanning the board and then *not*
    fixing anything (<= CHECK_FIX_MAX_SKIP wrong). That scan is an accurate,
    measured picture of the final board, and it was being thrown away — the
    next job paid another ~70 min sweep to learn what had just been measured.
    Track it with gridStateFromScan: set by scanGrid(), cleared by
    displayBitmap() before its first flip (so state that came from believed
    flips never counts as measured) and by ALARM recovery. At end of job,
    gridStateFresh now carries that value across the idle instead of being
    forced false, so the next job skips its scan when the last th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
    [PARMain.ino]
2026-08-13 PARMain: daily cadence — NTP clock, 10:00 lidar scan, 20:00 night sleep
    The rig now runs on a schedule instead of polling round the clock.
    Wall clock: NTP via configTzTime, TZ MST7MDT,M3.2.0,M11.1.0 as a named
    constant. Every cadence decision goes through localNow(), which refuses to
    report a time below TIME_VALID_FLOOR — the ESP32 RTC reads as 1970 long
    before SNTP fills it in, and acting on that would sleep at the wrong hour
    and stamp a scan against the epoch. No clock => the loop behaves exactly as
    it did before this change.
    Daily lidar scan at 10:00 local (or immediately, if we are past 10:00 and
    today's scan isn't on record — the reboot case). VL53L4CD mechanics ported
    from Scan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
    [PARMain.ino]
2026-08-13 PARMain: boot-time lidar init; FLOW.md drift fixes (POST next.php, lazy boot scan)
    Cherry-picked from the cadence-opus48 implementation of the same feature:
    surface a VL53L4CD wiring fault at boot instead of at the first 10:00 scan
    (lidarEnsure is idempotent, so the scan-time call still covers a late
    recovery), and correct two pre-existing FLOW.md drifts — next.php is POST,
    and the boot scanGrid() has been commented out in favor of the lazy first
    scan.
    [PARMain.ino]
2026-08-13 PARMain: 18:00 cutoff for an owed daily scan; epoch-target night sleep
    An owed lidar scan is now only started before 18:00 local — later than
    that the rig sleeps to 10:00 and scans on wake, instead of sweeping ~50
    minutes into the evening and then printing into the night.
    sleepUntilMorning() wakes on an epoch target (next 10:00 via mktime,
    DST-resolved) instead of "hour left the night window", because the
    past-cutoff case enters sleep as early as 18:00 where an hour-window
    test would exit after one tick. Backstop raised 15 h -> 17 h to cover
    the new longest legitimate sleep (18:00 -> 10:00 = 16 h).
    [PARMain.ino]
2026-08-13 PARMain: fail-closed clock rule, no night homing, night re-check loop, RAM-only scan fallback
    Applies all findings from the adversarial night-start review:
    - F1: cadenceGate re-tests night/owed-scan in a while loop after every
    wake, and re-verifies once more after the ~50-min morning sweep — a
    spurious backstop wake after an SNTP step can no longer fall through
    to a scan or poll at a night hour.
    - F2/F3: setup() never moves the gantry. GRBL bring-up + $H homing
    moved to grblBringup(), called only after cadenceGate passes (trusted
    clock AND daytime). HARD RULE: no time-server clock => no motion, no
    polling, not even homing; the uncadenced fallback is removed and the
    rig holds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
    [PARMain.ino]
2026-08-13 Servo rest angle 0° → 2° (544 → 565 µs) across all sketches
    The parked arm angle moves from 0° to 2°. On the Servo-lib 544–2400 µs /
    0–180° mapping that is 565 µs.
    Changed in all 20 SERVO_US_REST definitions, plus the three sketches that
    park at rest under another name: ServoCenter (SERVO_US_CENTER),
    ServoLoadTest (SERVO_US_A) and ServoLinkProbe (SERVO_US_PARK). ServoNano's
    power-on park moves too.
    544 also serves as the Servo-library 0° floor, and every such use is left
    alone: SERVO_US_0DEG / SERVO_US_MIN, compensatedUs()'s degree mapping,
    ServoNano's attach() range and its 544–2400 parse guard. ServoStallTest's
    angleToMicros() had been deriving the mapping from SERVO_U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
2026-08-16 Site: rename Upload tab to "Submit Art", link the logo home
    Navbar brand is now an <a> to /latest (non-selectable, no underline);
    showTab's active-link lookup is scoped to .navbar-menu so the brand
    doesn't steal the Latest item's active state.
    Also lands prior working-tree frontend edits: the "upload a photo
    instead" text link replacing the Upload Image button, and submission
    wording that says "submitted for review" rather than "added to the
    queue".
2026-08-17 TcsFilter honest labels, active-HIGH servo ack, PCB shield review
    Three related pieces of work.
    1. TcsFilter labels now name the PHYSICAL filter (13 sketches)
    The S2/S3 select lines are crossed on this rig, so the datasheet mapping
    does not hold for values 1 and 2. The enum carried the datasheet names and
    was therefore wrong on both. Relabelled TCS_CLEAR=1 / TCS_BLUE=2, swapped
    the reader so slot `b` holds blue and `c` holds clear, and pointed
    classifyDisc at `b`. classifyDisc still thresholds the SAME physical
    channel it always did.
    Pure relabel, verified by a host-compiled simulation of the extracted read
    path against the pre-relabel code: identical commanded (S2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
    [BOM_Board3_Shield_Schematic3_Shield_2026-08-16.xlsx]
2026-08-18 Read servo ack as an analog level; correct divider values in docs
    The rig is physically wired 2k/2k, not the 1.8k/3.3k that PINOUT.md and
    CLAUDE.md both claimed. Confirmed on the bench 2026-08-17. That puts the
    asserted ack level at 2.45-2.50 V against the ESP32-S3's V_IH of
    0.75*VDD = 2.475 V -- straddling the threshold.
    The old active-LOW protocol survived on this ratio by luck: the IDLE level
    with INPUT_PULLUP was 2.517 V, 42 mV of margin, which is why the 2026-07-27
    validation run passed. Yesterday's active-HIGH change plus INPUT_PULLDOWN
    inverted that into a permanent failure -- 2.446 V, below V_IH, so the ack
    would never assert, SERVO_ACK_MODE 2 would retry forever, and PARMain would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
    [BOM_Board3_Shield_Schematic3_Shield_2026-08-17_V2.xlsx]
2026-08-18 Shield rail: sequence peripherals up after the ESP32 boots (D11)
    Withdraws the earlier recommendation to fit a 100k pull-up on the TPS22919
    ON pin. That was driven by "a brownout must not cut servo power mid-flip",
    and netlist V3 made it obsolete by moving J7.1 to unswitched +5V. With the
    servo off the switched rail, a pull-up would only invert the default while
    giving up the sequencing the switch exists to provide.
    PARMain now drives D11 HIGH as the first statement in setup(). The rail stays
    fail-off and the board gets a deterministic power-on order: ESP32 first, then
    Mega/GRBL, ServoNano, lidar and colour sensor.
    Sequencing detail that would otherwise have bitten: the boot servo-park is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
    [PARMain.ino]
2026-08-18 REVIEW.md: fold in two blind audits, adjudicate against primary sources
    Two auditors reviewed the current design with no access to REVIEW.md, to any
    earlier revision, or to the firmware, as a check on whether the original
    four-pass findings were anchored. Both independently reproduced the substantive
    findings, and three separate measurement methods agree on the servo path to
    within 0.5 mOhm (43.86 / 44.3 / 44.4 mOhm).
    Nine disagreements are resolved against the primary source rather than by
    preferring an auditor:
    - TCS3200 VIH: 2.0 V ABSOLUTE, not 0.7*VDD (ams DS000107 v1-01 p.6). 3.3 V
    drive on S0-S3 is in spec at VDD=5V. Withdraws the concern raised earlier.
    - TCS3200 VOH: min 4.0 / ty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
2026-08-19 REVIEW.md: sharpen the decoupling recommendation
    The "zero decoupling anywhere" framing was accurate about the shield but
    misleading about the system. All three Arduino modules carry their own
    decoupling and bulk at their own supply pins and seat directly in the headers,
    so caps at J11, J5.12 or J2/J3 duplicate what is already there. Dropped.
    Also adds the constraint that makes more capacitance actively wrong in one
    place: the TPS22919's slew is fixed at 3.2 mV/us, so inrush = C * 3.2 mA/uF
    against a 1.5 A limit, and that budget is already partly spent charging the
    modules' own bulk on every turn-on (0.6-1.0 A at an estimated 200-300 uF).
    The switched rail can take a 10 uF ceramic and no mo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
2026-08-20 REVIEW.md: restructure by status, open items first; V5 files; ack stuck-line fault
    Document restructure, as requested: each finding now carries its resolution
    status inline at the point the claim is made, and the ordering is by status
    rather than chronological. Open items are first (blockers, then major, then
    minor), resolved items follow with the revision that closed them, withdrawn
    items last with the reason. Old IDs are retained in parentheses so earlier
    discussion stays traceable. The append-only revision log is gone -- it had
    grown to the point where a reader could not tell which claims still stood.
    715 -> 384 lines, with no technical content dropped.
    V5 review (Gerber V5 / Netlist V5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
    [BOM_Board3_Shield_PCB3_Shield_2026-08-19_V4.xlsx, BOM_Board3_Shield_Schematic3_Shield_2026-08-19_V3.xlsx]
2026-08-20 REVIEW.md: annotate claims in place instead of rewriting them
    The previous restructure was wrong. It reordered correctly but collapsed every
    resolved and withdrawn finding into a one-line table row, which deleted the
    original claim text -- so the claims were no longer stated at the point they
    were made, which was the actual request.
    Rebuilt from the pre-restructure document. Every finding now keeps its ORIGINAL
    body verbatim, with a status blockquote inserted directly beneath its heading
    recording what closed it or why it was retracted. Nothing is summarised away.
    Original IDs (B1-B4, C1-C12) are preserved rather than renumbered, so earlier
    discussion still resolves.
    Order is by status: bl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
2026-08-22 REVIEW.md: resolve O11 and O12; add the verified Schottky part for O13
    O11 - the LED anode feed is deliberate and now documented: the bank is powered
    from the TCS3200's 3V3 line, soldered at the sensor. The mechanism I warned
    about does not bite. ~160 mA (the module's own 4 LEDs plus 4 more) through the
    measured 22.6 mOhm of 3V3 copper is 3.6 mV of sensor-VDD droop; against the
    TCS3200's +/-0.5 %/V supply sensitivity that is a 0.002 % frequency shift, five
    orders of magnitude below the threshold margin. Conceded and marked resolved.
    One residual noted for a single check, not a respin: the 3V3 rail now carries
    that LED load on top of the ESP32's own draw from the Nano's onboard buck.
    O12 - w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
2026-08-22 REVIEW.md: V6 closes both blockers and six more; O17/O20 withdrawn
    Verified from netlist V6 / BOM V5:
    - O1 TVS: D2.1 on +5V, D2.2 on GND -- a proper shunt -- and J1.3 reaches +5V
    directly. Blocker closed. One BOM-only residual: still SMBJ5.0A, whose 5.0 V
    stand-off sits under a 5.25 V rail, so it will leak. Wants SMBJ6.0A/6.5A.
    - O2 C11: now CL31B106KAHNNNE, 10 uF 25 V. The 100 uF 6.3 V part is gone.
    - O3 polyfuse: moved out of the servo path. U4.6 -> U3 -> 5VSWED -> ServoNano,
    and via D3 to the Mega; the servo runs J1.3 -> +5V -> J7.1 unfused. U3 now
    sees ~330 mA against a 2 A hold instead of 89% of it.
    - O4/O5 Q2: now an AO3401A P-FET switching the HIGH side of the 3.3 V feed,
    w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
2026-08-22 REVIEW.md: V6 layout verified; new D3 finding overturns my own advice
    Layout pass on V6 confirms O6 and O10 resolved, and turns up four new items.
    O6 RESOLVED: the 45.7 mm run alongside SCL is gone (worst now 8.16 mm at
    152 um, LEDGT/SCL, worth a few mV into Q1's gate). The item that actually
    mattered is fine now -- $1N7075, the ack analog node, sits 1.69 mm from LEDGT
    and 6.27 mm from LED-, against 5.7 mm at 184 um before.
    O10 RESOLVED and conceded: C3/C4 taps went 10 -> 23 mil. Still single-via stubs
    carrying no DC current, but the loop is ~6-9 nH, i.e. ~1.3 mV for a 1.5 A step
    in 10 us. Harmless; this was a principle issue, not a functional one.
    NEW N1 -- and it overturns my own recomm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
2026-08-22 REVIEW.md: V7 removes D3 and adds 3V3 bypass; withdraw N5, resolve O14/O15
    V7 verified from the netlist and BOM:
    - N1 RESOLVED. D3 removed, $1N7047 gone, 5VSWED reaches J11.1/J11.2 directly.
    The Mega is back to ~4.93 V, 430 mV above its 4.5 V floor at 16 MHz. The
    back-feed hazard stays covered by R6 = 1 kOhm capping the QOD sink at ~5 mA.
    - N2 RESOLVED. C17 (100 nF) + C18 (10 uF) added from 3V3 to GND.
    Designer feedback processed:
    - N5 WITHDRAWN. Measured silk-in-opening area is 0.00000 mm^2 -- this was a
    registration-tolerance concern, not real overlap. Fabs clip silk off mask
    openings as standard, and an unclipped 0.04 mm sliver on a 1206/SOT-23 pad
    edge costs a negligible fract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
2026-08-22 REVIEW.md: V7 silk verified; N4 and O19 resolved, N3 downgraded
    Read from a render of the V7 top silkscreen:
    - N4 RESOLVED. J9 now reads "LED- SWI SWO". SW IN / SW OUT makes the
    pass-through unambiguous, so nobody will wire a switch across two pins that
    are the same net.
    - O19 RESOLVED. Title block reads "PARShield V0.7" and "2026-08-22" -- name,
    revision and date all present.
    - O15 confirmed in the render: J6 "3V3 GND SDA SCL", J8 "S0 S1 S2 S3 OUT 3V3
    GND", J7 "+5V GND SIG", J1 "+5V GND +12V" with arrows.
    N3 downgraded to optional. The nearest switched-rail cap to J8.6 is still C16
    at 11.98 mm / 24.4 mOhm (C13/C17 sit on 3V3, upstream of Q2). But re-costed:
    the load is the ~160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
2026-08-22 REVIEW.md: V7 verdict -- fabrication-ready; N6 closed; standing corrections added
    Final pre-fab pass on V7 (silk PARShield V0.7):
    READY TO FABRICATE. Full DFM sweep passes with margin. Copper matches the
    netlist exactly: 113 islands, 0 shorts, 0 opens, 0 floating copper, 0 pins
    without copper or a mask opening. The D3 removal was verified forensically --
    every one of 482 flashes maps to a pin or hole, no orphan pad, no gap, no stub
    in the 5VSWED trunk. Servo loop 51 mOhm / 77 mV at 1.5 A against the 0.2-0.3 V
    budget. Mega rail 4.93 V, 430 mV above its 4.5 V floor at 16 MHz. Ground is one
    region with returns of 1.25-5.54 mOhm. Zero silk in mask openings on both sides.
    N6 CLOSED: minimum hol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
2026-08-22 V8: C19 lands correctly; final reviewer's three blockers do not hold
    C19 (100 nF) added on CLRNLDRDRN in V8 and it landed where it was needed:
    4.52 mm from J8.6, 4.46 mm from J8.7, loop 12.8 mOhm, against C16's previous
    11.98 mm / 26.7 mOhm. N3 closed.
    The final independent reviewer returned "do not fabricate as-is" with three
    must-dos. Checked each against primary sources; none holds:
    - J7 -> KF301-5.0 for wire gauge. Premise wrong. LCSC's page for the exact BOM
    part gives KF128-2.54-3P as 8 A, 18-26 AWG. At 18 AWG a 0.5 m run adds 31 mV
    at 1.5 A, so board 79 mV + harness 31 mV = 110 mV against a 200-300 mV
    budget. Recorded as a standing correction.
    - U3 -> MF-NSMF050 (0.5 A). Would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
2026-08-29 REVIEW.md: independent V12 pass — copper clean, four items before ordering
    Re-verified Gerber V12 / Netlist V9 / BOM V8 (2026-08-29, silk PARShield
    V0.8.7) from scratch rather than carrying the V7 verdict forward: rasterised
    every layer at 12.5 um, labelled copper per layer, merged through the PTH
    list, and took pad->net truth from FlyingProbeTesting.json.
    Copper matches the netlist exactly: 113 nets, 113 galvanic islands, 0 shorts,
    0 opens, 0 floating copper. Servo loop 54.2 mOhm / 81 mV at 1.5 A. Mega rail
    4.93 V.
    New findings:
    - N8 J10/J11/J12 are bottom-side; this is a two-sided assembly job
    - N9 10 uF group went X7R -> X5R; C11's voltage rating needs confirming
    - N10 C5 changed ma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
2026-08-29 REVIEW.md: V13 pass — board is clear; only D2's part number left
    Re-verified Gerber V13 / Netlist V10 / BOM V9 (silk PARShield V0.8.8).
    Copper still matches the netlist exactly: 113 nets, 113 galvanic islands,
    0 shorts, 0 opens, 0 floating copper.
    V12 -> V13 is silk + pour only: every named component pad is at an identical
    coordinate, rotation, size and net; netlist byte-identical; BOM
    content-identical; outline and bottom copper unchanged.
    Closed:
    - N9 C13585 confirmed 10uF 50V X5R 1206 -- rating went UP, 25V -> 50V
    - N10 ERS1CM471F12OT confirmed 8mm dia / 3.5mm pitch / 12mm -- fits exactly
    - N11 silk in mask openings now 0.00000 mm2 both sides; legend removed
    - N13 top GND pour restor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
2026-08-30 Frontend: prints-done counter, crop rotate/zoom controls, mobile crop gestures
    - Home hero gains a prints-done stat filled from gallery.php.
    - Crop modal gets rotate-left/right, zoom in/out and a fit button, plus
    keyboard shortcuts and pointer-driven pan/pinch that own the gesture
    (touch-action: none, no text selection or long-press callout).
    - Page behind the crop modal is locked while it is open.
2026-08-30 Color classifier: threshold the `c` slot again; docs updated
    Reverses the 2026-08-20 move to slot `b`, which cost ~11x the error rate.
    Ground truth from a check-pass scan against its gallery.php bitmap gives
    best-achievable errors of b = 14 vs c = 6, and slot `b` populations overlap.
    SCAN_ON_BLUE_MAX -> SCAN_ON_CLEAR_MAX (900, geomean of the 3V3 cluster edges).
    CLAUDE.md, FLOW.md and PINOUT.md updated to match.
    [CollectColorAmbient.ino, CollectColorTrainingData.ino, ColorSensorTest.ino, FlipAllMaskedTest.ino, FlipAllTest.ino, FlipBottomRowBlueTest.ino, FlipLeftColumnTest.ino, PARMain.ino]
2026-08-30 Submit modal: brighter borders, optional artist credit, share block in the done email
    Three changes.
    1. Brighter submit-modal field borders — #444 was nearly invisible against the
    modal surface. Now #d9d9d9: near-white, deliberately not #fff so it doesn't
    fight the cyan focus ring.
    2. The completion email gains a share block below the gallery button: a
    "Submit more art" button, a "Text a friend" button (sms: with no recipient
    and the blurb prefilled), and a "Post on your socials:" row linking X,
    Facebook, Pinterest, LinkedIn and Reddit share intents.
    The logos are transparent-background PNGs attached inline by Content-ID.
    Gmail strips data: URIs and most clients blo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
2026-08-30 Gallery modal: scroll internally instead of running off-screen
    A completed entry stacks name + artist + bitmap + photo + a 16:9 recording,
    which exceeds the viewport on phones and short laptops. The overlay is
    position:fixed, so the page behind can't scroll to the overflow — the bottom of
    the modal was simply unreachable.
    Cap .gallery-item-modal-content to 90dvh (90vh fallback) and move its children
    into a .gallery-modal-scroll box that scrolls when it has to. The close button
    stays outside that box so it can't scroll out of reach, and overscroll-behavior
    keeps the scroll from chaining to the page at the ends.
    Measured at 480px wide: modal fits the viewport at 640/900/1200px tall, scroll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
2026-08-30 Submit modal: lighter field fill, retitle the modal and the first field
    - Field background #0d0d0d -> #222222, lighter than the #1a1a1a modal surface
    so the inputs read as raised wells rather than holes in the panel.
    - Placeholder #555 -> #7d7d7d. #555 was tuned against the old near-black fill
    and loses most of its contrast against #222; this keeps it roughly where it
    was.
    - Header "Add a name for your picture" -> "Add details to your art".
    - First field placeholder -> "Enter a title for your artwork...", and its
    validation message follows it from "A name is required." to "A title is
    required." so the two don't disagree about what the field is.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
2026-08-30 Share links: route SMS through an https page, put both links in the blurb
    Two fixes to the completion email's share block.
    1. The "Text a friend" button wasn't clickable. Gmail (and most webmail)
    sanitize anchor hrefs down to http/https/mailto and silently drop every
    other scheme, so the bare `sms:?&body=` href rendered as styled text that
    was not a link at all. The button now points at share-sms.php, a thin https
    landing page that hands off to the sms: URI from a real page. It
    auto-attempts the handoff only on coarse pointers, always offers the tap as
    the reliable path, and shows a copyable fallback on desktop where sms: has
    no handler. Its only input is a digits-only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
2026-08-31 YT-Streamer: upload resilience, backfill recovery, two-channel playlist support
    Two bodies of work that had accumulated uncommitted in the tree.
    Upload resilience and recovery:
    - upload_recording retries across transient network failures in two layers
    (chunk-level via next_chunk(num_retries=...) against the same resumable
    session, then whole-upload retries with exponential backoff). Previously a
    single socket blip abandoned a recording permanently.
    - complete.php arms snapshot-pending.flag when it performs the rename, giving
    the recording a second, flag-independent stop path so a lost
    snapshot-request.php can't let a recording run to the cap.
    - backfill_uploads.py + run_backfill.s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
2026-08-31 YT-Streamer: stop the auth flows logging live credentials
    requests_oauthlib logs the entire token response at DEBUG (access_token AND
    refresh_token in cleartext), and urllib3/oauthlib log the Authorization header
    carrying the client secret. YT_streamer puts the root logger at DEBUG, and the
    run_*.sh wrappers tee stdout to a world-readable file in /tmp — so a consent run
    wrote live credentials to plaintext disk, which is exactly what the encrypted
    DMG vault exists to prevent. Observed on the 2026-08-30 upload-token consent.
    Pin the noisy third-party loggers to WARNING in both scripts that run a consent
    flow, before any flow executes.
    C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
2026-08-31 Fix four integration bugs that silently lost work
    1. The board hot-looped on a short bitmap and drained the queue.
    PARMain.ino's `bad decode length` branch logged and fell straight out of
    loop() with no delay, unlike every sibling error path. loop() ends there, so
    the next iteration immediately re-POSTed next.php — which pops a queue item
    per call. One truncated response would drain the whole queue in seconds,
    stranding a pending gallery entry, and a bound-but-unsendable submitter
    email, for every item. Added the same 10s back-off the siblings use.
    2. A failed video_id POST destroyed the recording.
    _post_video_id() was a single un-retried POST whose result was discard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
    [PARMain.ino]
2026-08-31 Add Privacy Policy and Terms of Service pages for YouTube OAuth publishing
    Standalone privacy.html and terms.html for par.zimmzimm.com, required to
    publish the YT-Streamer app's OAuth consent screen. Privacy policy discloses
    YouTube API Services use and links the YouTube ToS and Google Privacy Policy.
    Also corrects CLAUDE.md's display description: flip-disc, not LED matrix.
    Claude-Session: https://claude.ai/code/session_0192ck7EfB2pVkKJNFdmQVfV
2026-08-31 Fix gallery modal video being vertically crushed
    The modal scroll box is a column flex container with max-height; flex
    children shrink by default, so the bitmap canvas, the photo and the 16/9
    recording box were squashed to fit instead of overflowing. Pin every
    direct child to its natural size so the container scrolls instead.
2026-09-01 Prepend a 125x timelapse intro to every YouTube upload
    Uploads are now "<whole print at 125x> + <whole print at 1x>" with a black
    bottom-right label naming the speed of each half. The RATE is fixed, not the
    intro duration, so every video reads at the same pace and the label is the
    same number every time (45-min print -> 21.6s intro).
    Labels are Pillow-rendered PNGs composited with `overlay`, not `drawtext` --
    the Homebrew ffmpeg here is built without libfreetype, so drawtext does not
    exist in it.
    Composition is three ffmpeg passes (timelapse / real-time / concat-remux).
    Pass A decodes keyframes only when a per-recording probe confirms they are
    dense enough to fill the intro; AVCaptureMovie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
2026-09-01 Report each moderation check's own duration, not cumulative elapsed
    The blank-artist short-circuit already spends no SDK session (check_artist('')
    returns in 0.0000s), but the log made it look like a 6-9s model call: the three
    checks run concurrently yet are read back sequentially, and every "check done
    in" line printed `now - batch_start`. So the artist check was credited with the
    name check's wall time -- 5.8s/5.8s, 8.9s/8.9s in the two most recent reviews,
    which is exactly why it read as a wasted session.
    _timed_check() now returns (result, own_seconds), and a blank artist logs
    "artist check SKIPPED (no artist name) - no SDK call" so the distinction is
    visible in stream.log. No change to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
2026-09-01 Mark programmatic verdicts in the moderator email
    The blank-artist short-circuit returns the same fields as a real check --
    verdict, confidence, flags, reasoning -- so the moderator email presented its
    hardcoded "no artist name given" string as though Claude had written it. There
    was no way to tell an automatic approve from a model judgement.
    The synthetic result now carries model_called=False, and _render_result gives
    it a "Skipped automatically - no Claude call was made" banner stating the
    verdict and reasoning were generated programmatically. Real verdicts label
    theirs "Model reasoning" for contrast. Exception rendering is unchanged.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
2026-09-01 Replace hero video with 125x three-print timelapse
    Cai, Slinking Through the Night, and Okami Wolf, each sped up 125x
    and joined with straight cuts (57.5s total, 1280x720, no audio).
2026-09-01 Set a custom thumbnail on every YouTube upload
    Snapshot photo of the finished board + large yellow "Watch it print!"
    across the bottom, font-fitted to span the full width minus equal side
    margins (ink-exact via a cropped RGBA layer — textbbox over-reports the
    trailing glyph bearing and unbalances the margins). Set via
    thumbnails.set on the upload token right after the gallery attach;
    best-effort like the playlist step, so a failure never costs an upload.
    The snapshot poller parks a per-id copy before upload_snapshot unlinks
    its input; the site's gallery/<id>/image.jpg is the fallback source,
    which also lets backfill set thumbnails for recovered uploads.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
2026-09-01 Autoplay gallery modal recording once fully in view
    The modal's YouTube embed mounted paused and needed a click. It now starts
    muted as soon as the embed is fully within the visible area — immediately on
    open when it already is, otherwise on the scroll that brings it in.
    An IntersectionObserver on the video container fires once and disconnects, so
    pausing and scrolling away/back doesn't restart playback. Embeds taller than
    the viewport can never reach ratio 1, so filling the visible area counts as
    fully in view. Playback is deferred until the player's onReady when the
    observer fires first; the existing near-end seek still runs off first PLAYING.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
2026-09-01 Play the gallery modal recording from the start
    Now that the modal autoplays, opening 10s before the end means the video is
    over almost immediately. Skip the near-end seek there and play the print
    through from the top.
    createNearEndPlayer takes `nearEnd` (default true), so the Latest tab still
    opens on the finished board.
2026-09-02 Add PCB3 Shield fab assets (V5-V14) and lidar pass-1 HTML
    Gerber/BOM/Netlist exports for board revisions V5 through V14, plus the
    single-page lidar pass-1 HTML.
    Claude-Session: https://claude.ai/code/session_01CuBHm3ipXp7hXpzK3zZiKy
    [BOM_Board3_Shield_PCB3_Shield_2026-08-22_V5.xlsx, BOM_Board3_Shield_PCB3_Shield_2026-08-22_V6.xlsx, BOM_Board3_Shield_PCB3_Shield_2026-08-22_V7.xlsx, BOM_Board3_Shield_PCB3_Shield_2026-08-29_V10.xlsx, BOM_Board3_Shield_PCB3_Shield_2026-08-29_V8.xlsx, BOM_Board3_Shield_PCB3_Shield_2026-08-29_V9.xlsx]
2026-09-02 Add set_claude_token.sh to pin the moderation poller's Claude token
    The poller's SDK calls authenticate through the CLI's login Keychain
    credential, which goes stale whenever an SSH Claude session rotates the
    file-based grant instead — the Aug 2026 mod-check 401s. A long-lived
    setup-token in .env takes priority over both and removes that coupling.
    The token is read with `read -s`, so it never reaches argv or shell
    history, and .env is gitignored. The rewrite is atomic (temp file at
    0600, then mv) and delimited by markers so re-running replaces the block
    rather than accumulating copies.
    Claude-Session: https://claude.ai/co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
2026-09-07 Night sleep starts at 20:30, with minute granularity
    isNightHour() only took an hour, so the night boundary could only ever land
    on the hour. Give it a minute component (NIGHT_START_MIN) and move the start
    from 20:00 to 20:30, so the rig keeps ingesting for the first half of the
    evening hour instead of parking at 20:00 sharp.
    The 10:00 wake end stays on the hour, so only the start needs minutes. All
    three call sites (the cadence gate's night loop, the post-scan re-verify, and
    the post-print check in runPendingJob) pass tm_min through -- the predicate is
    still written once so they cannot disagree about the boundary.
    FLOW.md updated in the same edit per the drift rule.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
    [PARMain.ino]
2026-09-07 PARMain: skip the top row in the daily lidar scan, project it instead
    At the lidar Y (+14.0, vs the colour sensor's +8.0) the head jams against the
    frame across the right-hand end of row 0. ScanColorLidarTest got LIDAR_SKIP_TOP_ROW
    for this on 2026-08-26; PARMain was missed, on the stated grounds that it "only
    consumes LIDAR_FIT_CMM, it doesn't measure" -- but runDailyLidarScan had landed
    two weeks earlier (1d35db5, 2026-08-12). So the daily 10:00 sweep has been driving
    into the jam ever since.
    Worse, row 0 is an EVEN row, so cellAt sweeps it L->R and the sweep *ends* the row
    at col 36 -- target (X 0.0, Y -0.2), hard into the corner -- and row 0 is visited
    first. A jam need not raise ALARM;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
    [PARMain.ino]
2026-09-07 Gallery/Latest: survive content blockers killing YouTube telemetry
    Every gallery recording flashed on for ~0.5s and then vanished behind an ad
    blocker. The embed itself was fine and still playing -- what the blocker killed
    was YouTube's telemetry pings (generate_204 / youtubei log_event), which the
    IFrame API surfaces as onError. We treated any onError as "video is gone" and
    tore the player down, so a working embed got blanked half a second after it
    appeared.
    The distinguishing signal is whether onReady already fired: once the player
    reports ready the video is confirmed loaded and embeddable, so a LATER error is
    almost always telemetry, not an unavailable video.
    - createNearEndPlayer track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
